PietPtr/MultiEffectsPico/README.md

# mep

Experiments for building a multi-effects processor on a Raspberry Pi Pico using I2S ADC's / DAC's and other IO for configuration
