PietPtr/MultiEffectsPico/fingybass/IDEA.md

# Board

Custom fit PCB that fits precisely at the bottom of the housing in the fingybass with:

1) Two PCM1808 ADCs, one connected to the pickup, one to AUX 3.5mm in

2) A PCM5102 DAC connected to the 3.5mm out

3) an RPi pico (maybe a wireless one?)

4) Battery + a charging module

Additionally, a PCB that fits behind a new 3D printed inset backplate with:

1) 1-bit OLED display

2) 1 encoder (e.g. EC12E24104A6, crate: rotary-encoder-embedded)

3) 4 push buttons (kailh silent)

4) 2 toggle switch

5) Persistent storage? An SD card?

# User Interface
