PietPtr/MultiEffectsPico/pcbs/devkit/devkit.kicad_pcb

## KiCad design pcbs/devkit/devkit.kicad_pcb (2025-06-25)

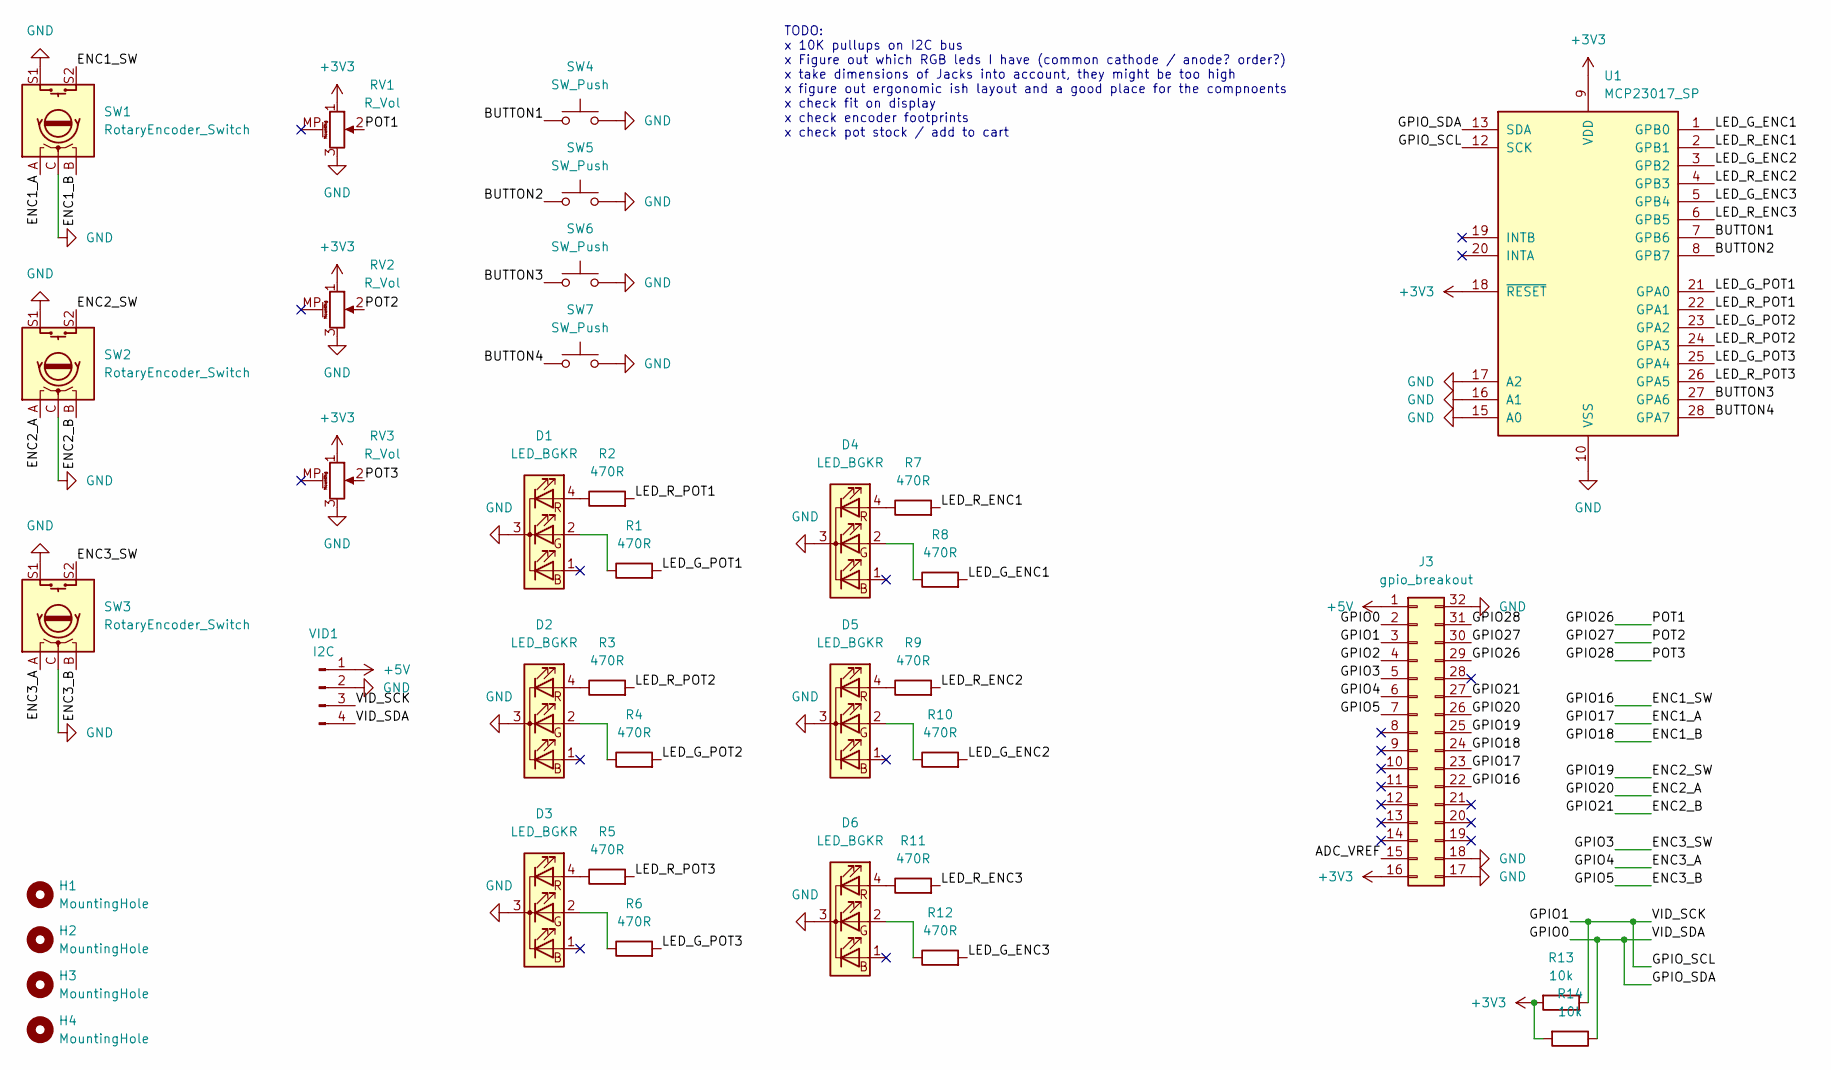
[picture p1: schematic devkit.kicad_sch]

Parts:
D1, D2, D3, D4, D5, D6: LED_BGKR; LED_D5.0mm-4_RGB
H1, H2, H3, H4: MountingHole; MountingHole_3.2mm_M3
J3: gpio_breakout; PinSocket_2x16_P2.54mm_Vertical
R1, R2, R3, R4, R5, R6, R7, R8, R9, R10, R11, R12: 470R; R_Axial_DIN0207_L6.3mm_D2.5mm_P7.62mm_Horizontal
R13, R14: 10k; R_Axial_DIN0207_L6.3mm_D2.5mm_P7.62mm_Horizontal
RV1, RV2, RV3: R_Vol; Potentiometer_Alps_RK09K_Single_Vertical
SW1, SW2, SW3: RotaryEncoder_Switch; RotaryEncoder_Alps_EC11E-Switch_Vertical_H20mm_MountingHoles
SW4, SW5, SW6, SW7: SW_Push; KAILH_MUTE
U1: MCP23017_SP; DIP-28_W7.62mm
VID1: I2C; PinHeader_1x04_P2.54mm_Vertical

Connections:
+3V3: J3.16, R13.2, R14.2, RV1.1, RV2.1, RV3.1, U1.9 (VDD), U1.18 (~RESET)
+5V: J3.1, VID1.1
/ADC_VREF: J3.15
/BUTTON1: SW4.1, U1.7 (GPB6)
/BUTTON2: SW5.1, U1.8 (GPB7)
/BUTTON3: SW6.1, U1.27 (GPA6)
/BUTTON4: SW7.1, U1.28 (GPA7)
/ENC1_A: J3.23, SW1.A
/ENC1_B: J3.24, SW1.B
/ENC1_SW: J3.22, SW1.S2
/ENC2_A: J3.26, SW2.A
/ENC2_B: J3.27, SW2.B
/ENC2_SW: J3.25, SW2.S2
/ENC3_A: J3.6, SW3.A
/ENC3_B: J3.7, SW3.B
/ENC3_SW: J3.5, SW3.S2
/GPIO0: J3.2, R14.1, U1.13 (SDA), VID1.4
/GPIO1: J3.3, R13.1, U1.12 (SCK), VID1.3
/GPIO2: J3.4
/GPIO26: J3.29, RV1.2
/GPIO27: J3.30, RV2.2
/GPIO28: J3.31, RV3.2
/LED_G_ENC1: R8.2, U1.1 (GPB0)
/LED_G_ENC2: R10.2, U1.3 (GPB2)
/LED_G_ENC3: R12.2, U1.5 (GPB4)
/LED_G_POT1: R1.2, U1.21 (GPA0)
/LED_G_POT2: R4.2, U1.23 (GPA2)
/LED_G_POT3: R6.2, U1.25 (GPA4)
/LED_R_ENC1: R7.2, U1.2 (GPB1)
/LED_R_ENC2: R9.2, U1.4 (GPB3)
/LED_R_ENC3: R11.2, U1.6 (GPB5)
/LED_R_POT1: R2.2, U1.22 (GPA1)
/LED_R_POT2: R3.2, U1.24 (GPA3)
/LED_R_POT3: R5.2, U1.26 (GPA5)
GND: D1.3 (K), D2.3 (K), D3.3 (K), D4.3 (K), D5.3 (K), D6.3 (K), J3.17, J3.18, J3.32, RV1.3, RV2.3, RV3.3, SW1.C, SW1.S1, SW2.C, SW2.S1, SW3.C, SW3.S1, SW4.2, SW5.2, SW6.2, SW7.2, U1.10 (VSS), U1.15 (A0), U1.16 (A1), U1.17 (A2), VID1.2
unnamed: D1.2 (GA), R1.1
unnamed: D1.4 (RA), R2.1
unnamed: D2.2 (GA), R4.1
unnamed: D2.4 (RA), R3.1
unnamed: D3.2 (GA), R6.1
unnamed: D3.4 (RA), R5.1
unnamed: D4.2 (GA), R8.1
unnamed: D4.4 (RA), R7.1
unnamed: D5.2 (GA), R10.1
unnamed: D5.4 (RA), R9.1
unnamed: D6.2 (GA), R12.1
unnamed: D6.4 (RA), R11.1

Notes on the sheet:
TODO: x 10K pullups on I2C bus x Figure out which RGB leds I have (common cathode / anode? order?) x take dimensions of Jacks into account, they might be too high x figure out ergonomic ish layout and a good place for the compnoents x check fit on display x check encoder footprints x check pot stoc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

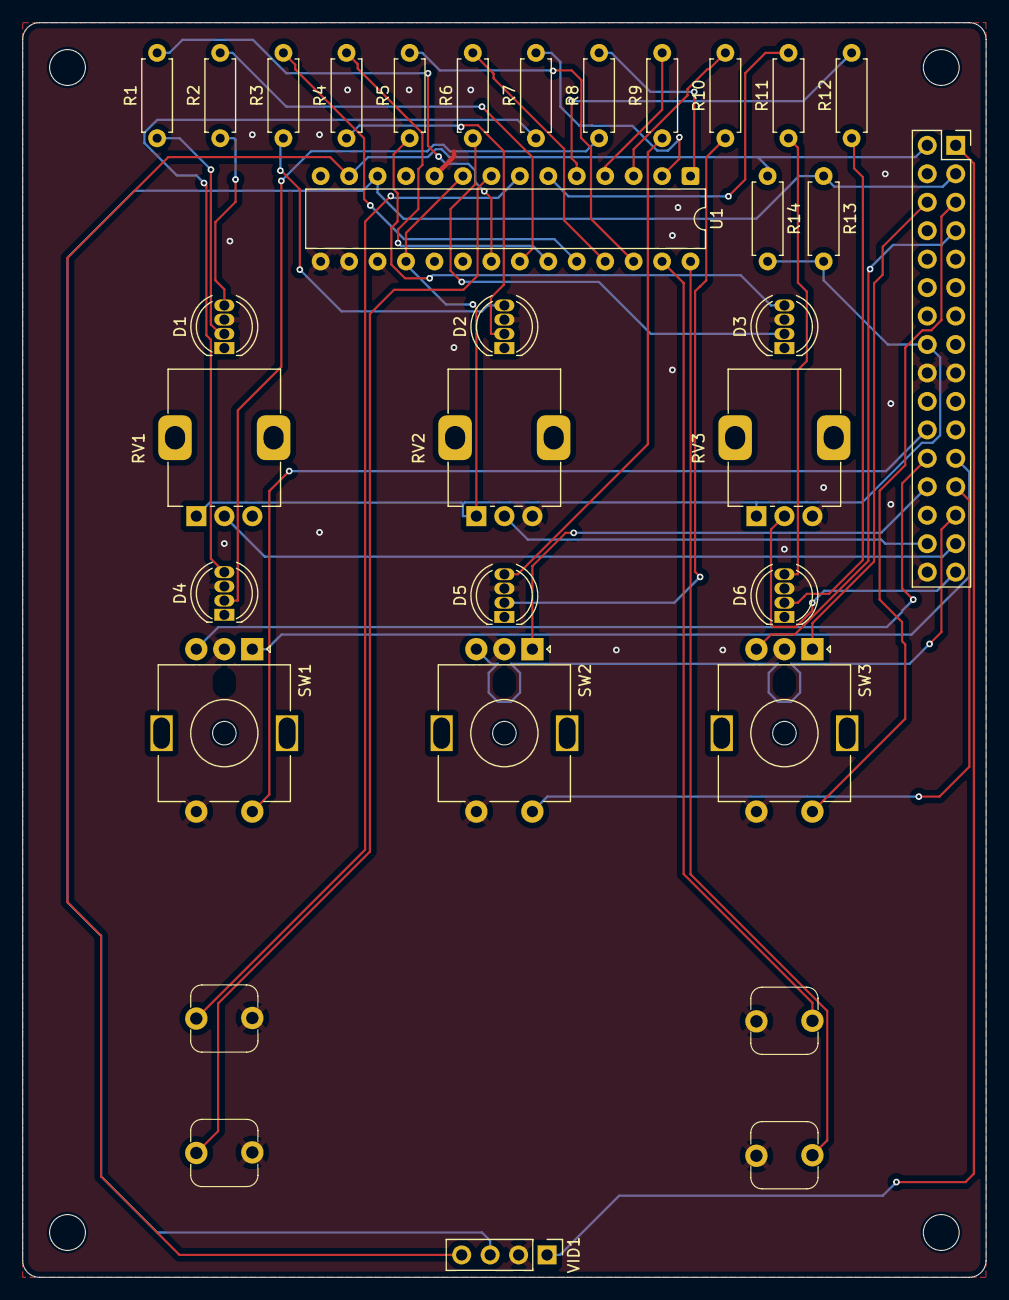
[picture p2: board devkit.kicad_pcb from above]

Board: 2 copper layers, 86.0 x 112.0 mm, 37 parts (0 on the bottom side), 45 nets.
