PietPtr/MultiEffectsPico/pcbs/baseboard/baseboard.kicad_pcb

## KiCad design pcbs/baseboard/baseboard.kicad_pcb (2025-06-25)

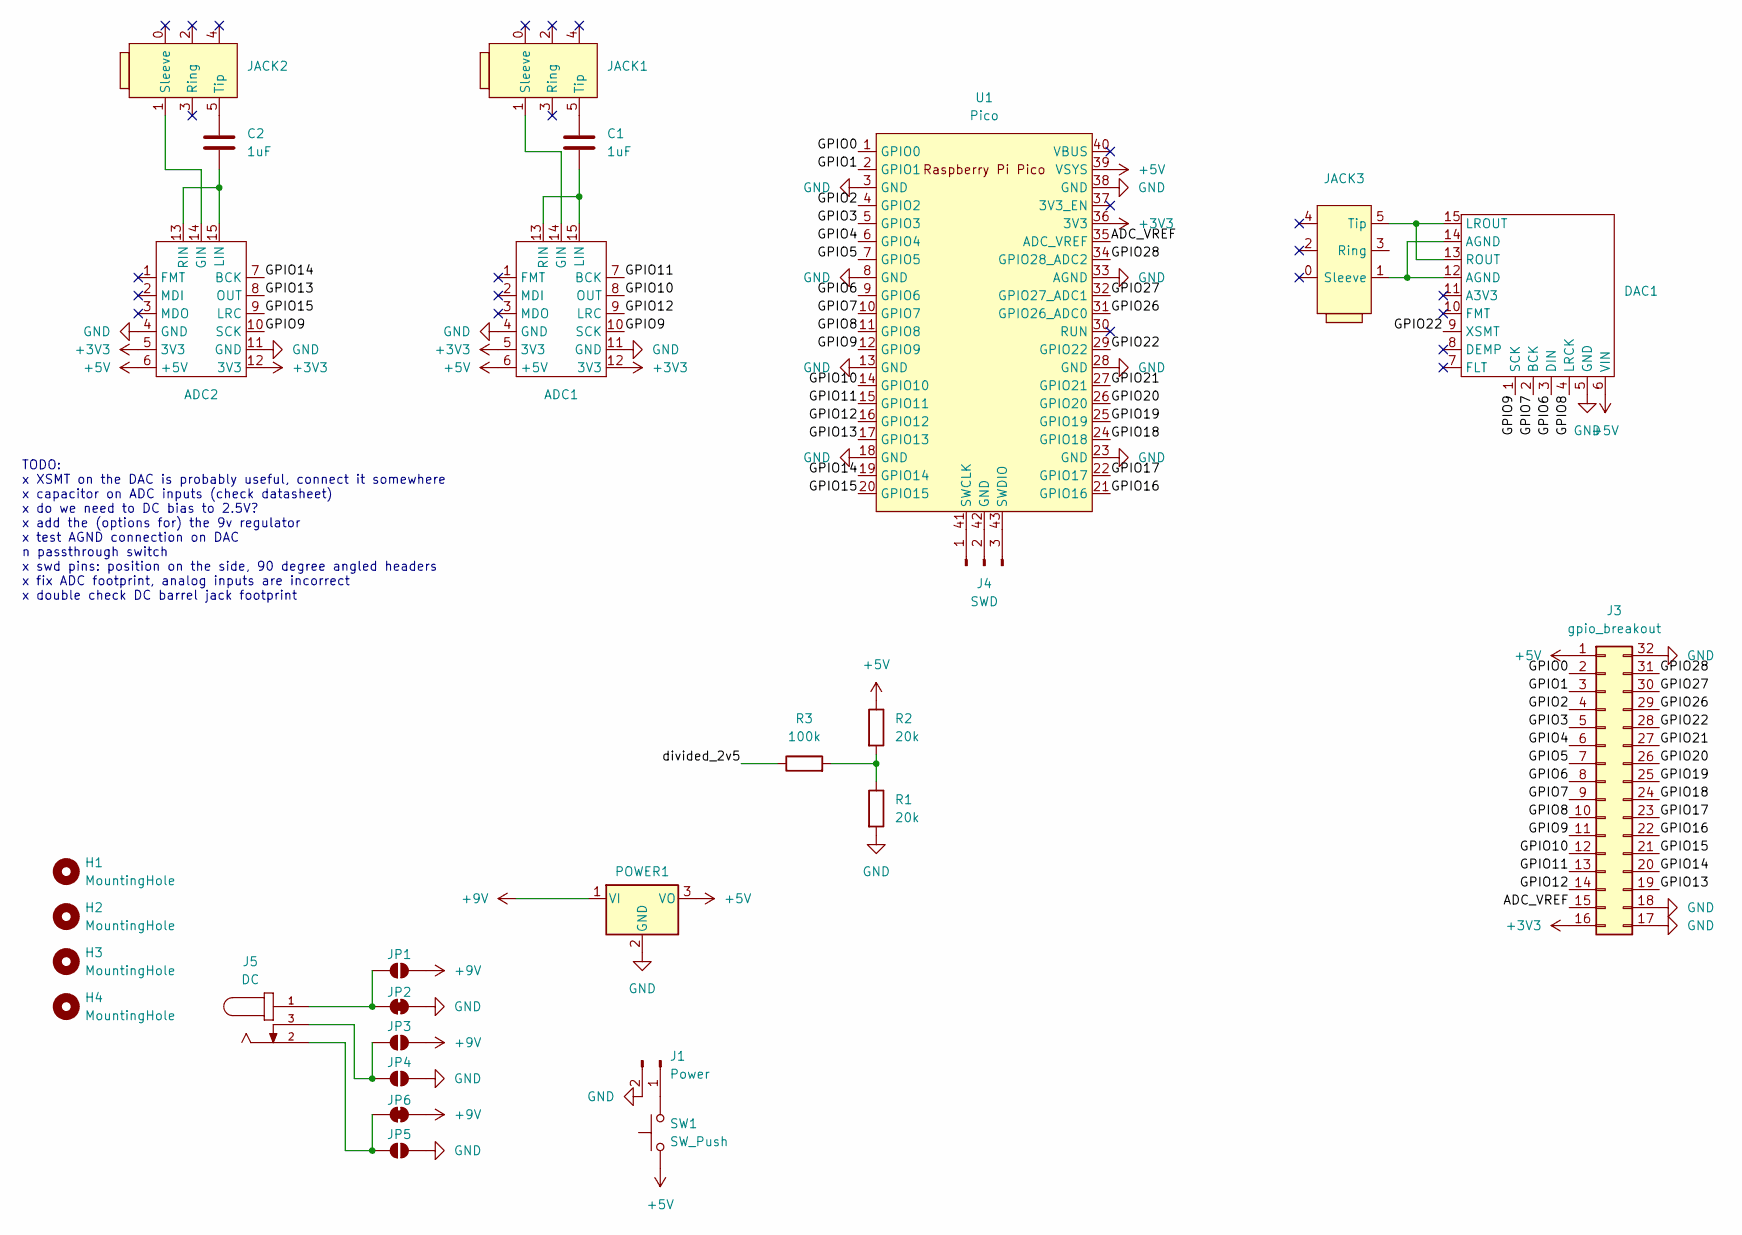
[picture p3: schematic baseboard.kicad_sch]

Parts:
ADC1, ADC2: PCM1808_breakout
C1, C2: 1uF; C_Radial_D5.0mm_H11.0mm_P2.00mm
DAC1: PCM5102_BREAKOUT
H1, H2, H3, H4: MountingHole; MountingHole_3.2mm_M3
J1: Power; PinHeader_1x02_P2.54mm_Vertical
J3: gpio_breakout; PinSocket_2x16_P2.54mm_Vertical
J4: SWD; PinHeader_1x03_P2.54mm_Vertical
J5: DC; GCT_DCJ200-10-A-XX-K_REVA; PARTREV A
JACK1, JACK2, JACK3: SlimJack6.3
JP1, JP3, JP4, JP5: SolderJumper-2_P1.3mm_Open_RoundedPad1.0x1.5mm
JP2, JP6: SolderJumper-2_P1.3mm_Bridged_RoundedPad1.0x1.5mm
POWER1: LM7805_TO220; TO-220-3_Horizontal_TabDown
R1, R2: 20k; R_Axial_DIN0207_L6.3mm_D2.5mm_P7.62mm_Horizontal
R3: 100k; R_Axial_DIN0207_L6.3mm_D2.5mm_P7.62mm_Horizontal
SW1: SW_Push; PinHeader_1x03_P2.54mm_Vertical
U1: Pico; RPi_Pico_SMD_TH

Connections:
+3V3: ADC1.5 (3V3), ADC1.12 (3V3), ADC2.5 (3V3), ADC2.12 (3V3), J3.16, U1.36 (3V3)
+5V: ADC1.6 (+5V), ADC2.6 (+5V), DAC1.6 (VIN), J3.1, POWER1.3 (VO), R2.1, SW1.1, U1.39 (VSYS)
+9V: JP1.2 (B), JP3.2 (B), JP6.2 (B), POWER1.1 (VI)
/ADC_VREF: J3.15, U1.35 (ADC_VREF)
/GPIO0: J3.2, U1.1 (GPIO0)
/GPIO1: J3.3, U1.2 (GPIO1)
/GPIO2: J3.4, U1.4 (GPIO2)
/GPIO3: J3.5, U1.5 (GPIO3)
/GPIO4: J3.6, U1.6 (GPIO4)
/GPIO5: J3.7, U1.7 (GPIO5)
/GPIO6: DAC1.3 (DIN), J3.8, U1.9 (GPIO6)
/GPIO7: DAC1.2 (BCK), J3.9, U1.10 (GPIO7)
/GPIO8: DAC1.4 (LRCK), J3.10, U1.11 (GPIO8)
/GPIO9: ADC1.10 (SCK), ADC2.10 (SCK), DAC1.1 (SCK), J3.11, U1.12 (GPIO9)
/GPIO10: ADC1.8 (OUT), J3.12, U1.14 (GPIO10)
/GPIO11: ADC1.7 (BCK), J3.13, U1.15 (GPIO11)
/GPIO12: ADC1.9 (LRC), J3.14, U1.16 (GPIO12)
/GPIO13: ADC2.8 (OUT), J3.19, U1.17 (GPIO13)
/GPIO14: ADC2.7 (BCK), J3.20, U1.19 (GPIO14)
/GPIO15: ADC2.9 (LRC), J3.21, U1.20 (GPIO15)
/GPIO16: J3.22, U1.21 (GPIO16)
/GPIO17: J3.23, U1.22 (GPIO17)
/GPIO18: J3.24, U1.24 (GPIO18)
/GPIO19: J3.25, U1.25 (GPIO19)
/GPIO20: J3.26, U1.26 (GPIO20)
/GPIO21: J3.27, U1.27 (GPIO21)
/GPIO22: DAC1.9 (XSMT), J3.28, U1.29 (GPIO22)
/GPIO26: J3.29, U1.31 (GPIO26_ADC0)
/GPIO27: J3.30, U1.32 (GPIO27_ADC1)
/GPIO28: J3.31, U1.34 (GPIO28_ADC2)
/divided_2v5: R3.1
GND: ADC1.4 (GND), ADC1.11 (GND), ADC2.4 (GND), ADC2.11 (GND), DAC1.5 (GND), J1.2, J3.17, J3.18, J3.32, JP2.2 (B), JP4.2 (B), JP5.2 (B), POWER1.2 (GND), R1.2, U1.3 (GND), U1.8 (GND), U1.13 (GND), U1.18 (GND), U1.23 (GND), U1.28 (GND), U1.33 (AGND), U1.38 (GND)
unnamed: ADC1.14 (GIN), JACK1.1 (Sleeve)
unnamed: ADC1.13 (RIN), ADC1.15 (LIN), C1.2
unnamed: ADC2.14 (GIN), JACK2.1 (Sleeve)
unnamed: ADC2.13 (RIN), ADC2.15 (LIN), C2.2
unnamed: DAC1.13 (ROUT), DAC1.15 (LROUT), JACK3.5 (Tip)
unnamed: J1.1, SW1.2
unnamed: J4.1, U1.41 (SWCLK)
unnamed: J4.2, U1.42 (GND)
unnamed: J4.3, U1.43 (SWDIO)
unnamed: C1.1, JACK1.5 (Tip)
unnamed: C2.1, JACK2.5 (Tip)
unnamed: DAC1.12 (AGND), DAC1.14 (AGND), JACK3.1 (Sleeve)
unnamed: J5.1, JP1.1 (A), JP2.1 (A)
unnamed: J5.3, JP3.1 (A), JP4.1 (A)
unnamed: J5.2, JP5.1 (A), JP6.1 (A)
unnamed: R1.1, R2.2, R3.2

Notes on the sheet:
TODO: x XSMT on the DAC is probably useful, connect it somewhere x capacitor on ADC inputs (check datasheet) x do we need to DC bias to 2.5V? x add the (options for) the 9v regulator x test AGND connection on DAC n passthrough switch x swd pins: position on the side, 90 degree angled headers x fix 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

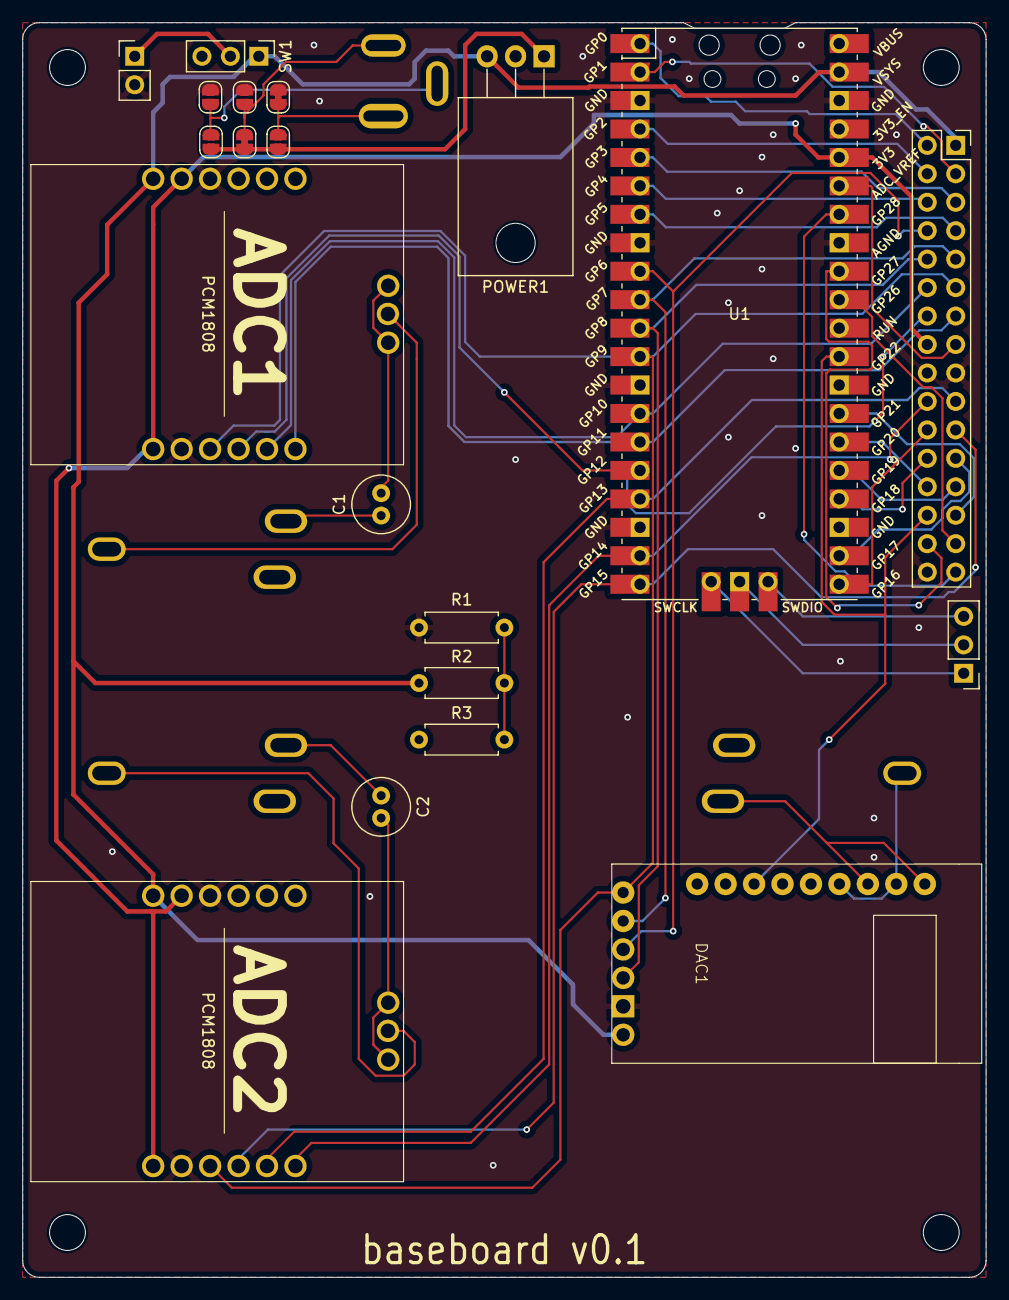
[picture p4: board baseboard.kicad_pcb from above]

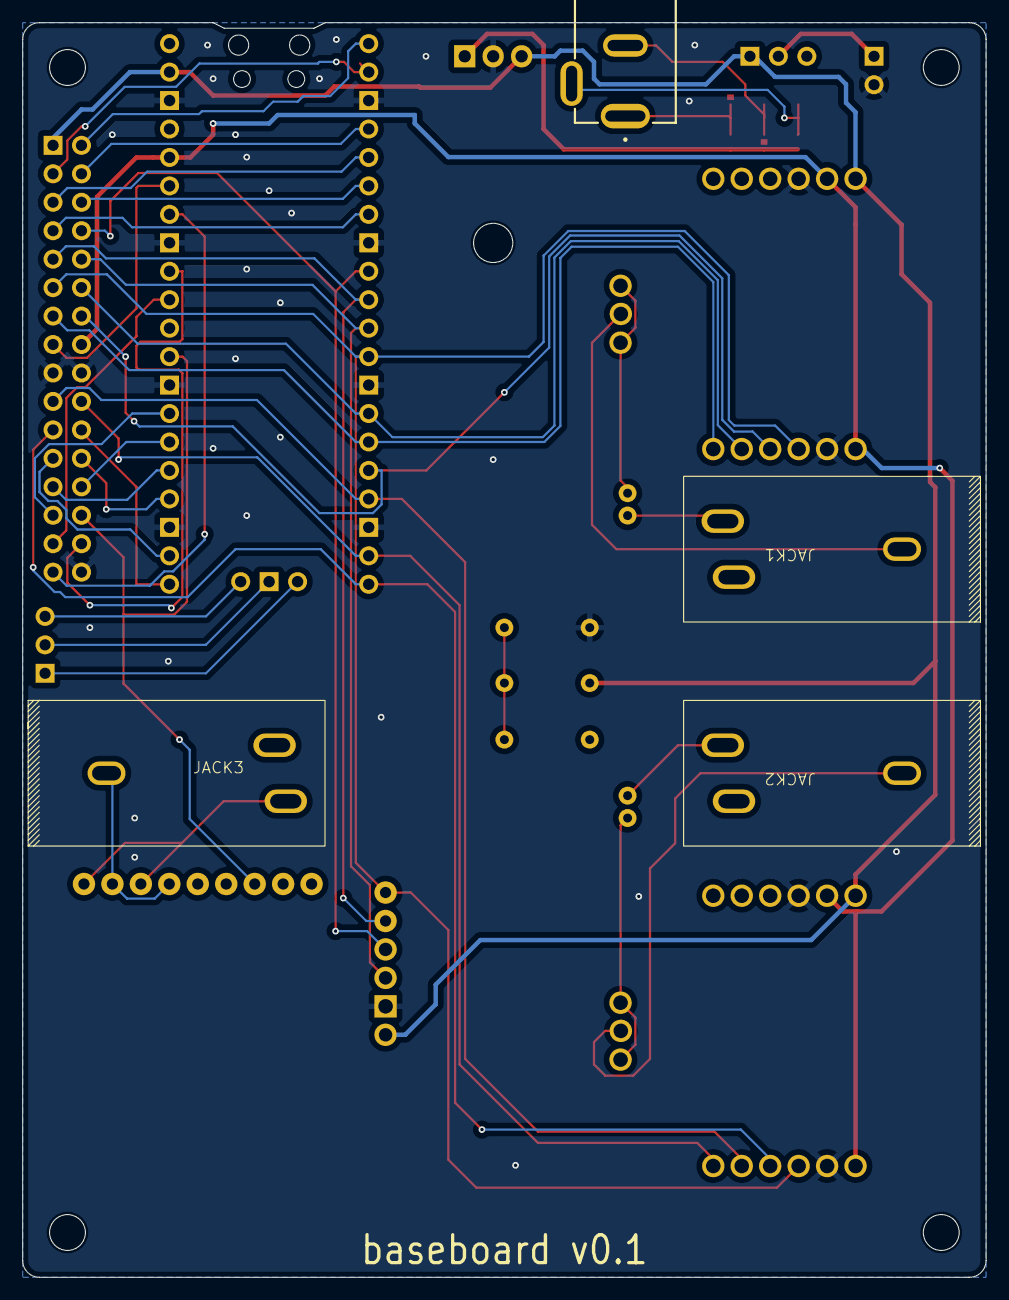
[picture p5: board baseboard.kicad_pcb from below]

Board: 2 copper layers, 86.0 x 112.0 mm, 28 parts (4 on the bottom side), 47 nets.
