PietPtr/MultiEffectsPico/(commit log)

2025-06-19 Add schema of baseboard PCB
    [baseboard.kicad_pcb, baseboard.kicad_sch]
2025-06-20 Add devkit and fingybass crates
    [baseboard.kicad_pcb]
2025-06-24 Expand baseboard + devkit
    [baseboard.kicad_pcb, baseboard.kicad_sch, devkit.kicad_pcb, devkit.kicad_sch]
2025-06-25 Order baseboard and devkit
    [baseboard-B_Cu.gbr, baseboard-B_Mask.gbr, baseboard-B_Paste.gbr, baseboard-B_Silkscreen.gbr, baseboard-Edge_Cuts.gbr, baseboard-F_Cu.gbr, baseboard-F_Mask.gbr, baseboard-F_Paste.gbr]
2025-07-19 Validate devkit and baseboard v0.1
    [baseboard.kicad_sch]
2025-07-23 Test freqmon
    [baseboard.kicad_sch]
2025-07-25 Add prototype breath controller
    [devkit.kicad_sch]
